hsetlik/Handyman_TunerGate/Simulations/AttenuatorSim.asc

C1: cap; 100n
C2: cap; 47n
C3: cap; 100n
D1: diode; 1N4148
D2: diode; 1N4148
D3: diode; 1N4148
D4: diode; 1N4148
D5: diode; 1N4148
Q1: npn; BC847B
R1: res; 47k
R2: res; 470k
R3: res; 470k
R4: res; 470k
R5: res; 470k
R6: res; 470k
R7: res; 51k
R8: res; 100k
R9: res; 51k
R10: res; 100k
R11: res; 100k
R12: res; 47k
R13: res; 10k
R14: res; 10k
R15: res; 47k
U1: LT1058
U2: LT1058
U3: LT1058
U4: LT1058
U5: LT1058
V1: voltage; PULSE(3.3 0 650m 100u 100u 90m 150m 1)
V2: voltage; 9
V3: voltage; SINE(0 0.4 220)
Named nets: +9, 0, vg, gate, IN, CATH, AN, out
.tran 0 800m 600m
