hsetlik/Handyman_TunerGate/Simulations/ThreshDetectorSim.asc

C1: cap; 470n
C2: cap; 4.7n
C3: cap; 1µ
C4: cap; 100n
C5: cap; 10n
D1: diode; 1N4148
D2: diode; 1N4148
D3: diode; 1N4148
Q1: pnp; BC857A
Q2: pnp; BC857A
R1: res; 4.7k
R2: res; 100k
R3: res; 680
R4: res; 680
R5: res; 4.7k
R6: res; 91k
R7: res; 2k7
R8: res; 470k
R9: res; 22k
R10: res; 100k
R11: res; 100k
R12: res; 820
R13: res; 5k6
R14: res; 100k
R15: res; 100k
R16: res; 50k
R17: res; 100k
R18: res; 470k
R19: res; 10k
R20: res; 100k
U1: LM13700
U2: LT1058
U3: LT1058
U4: LT1058
U6: LT1058
U7: LT1058
U8: LT1058
V1: voltage; SINE(0 0.1 440)
V2: voltage; 9
V3: voltage; 9
V4: voltage; PULSE(0 3.3 600m 10m 60m 30m 100m 1)
Named nets: 0, +9, -9, GTR, vg, rect, env
.tran 0 800m 600m
.lib lm13700.sub
Ignore this it's just a convenient way to simulate a guitar signal
R19 = decay control 10k
