hsetlik/Handyman_TunerGate/HandymanSchematic_F4/HandymanSchematic_F4.kicad_pcb

## KiCad design HandymanSchematic_F4/HandymanSchematic_F4.kicad_pcb (2026-10-26)

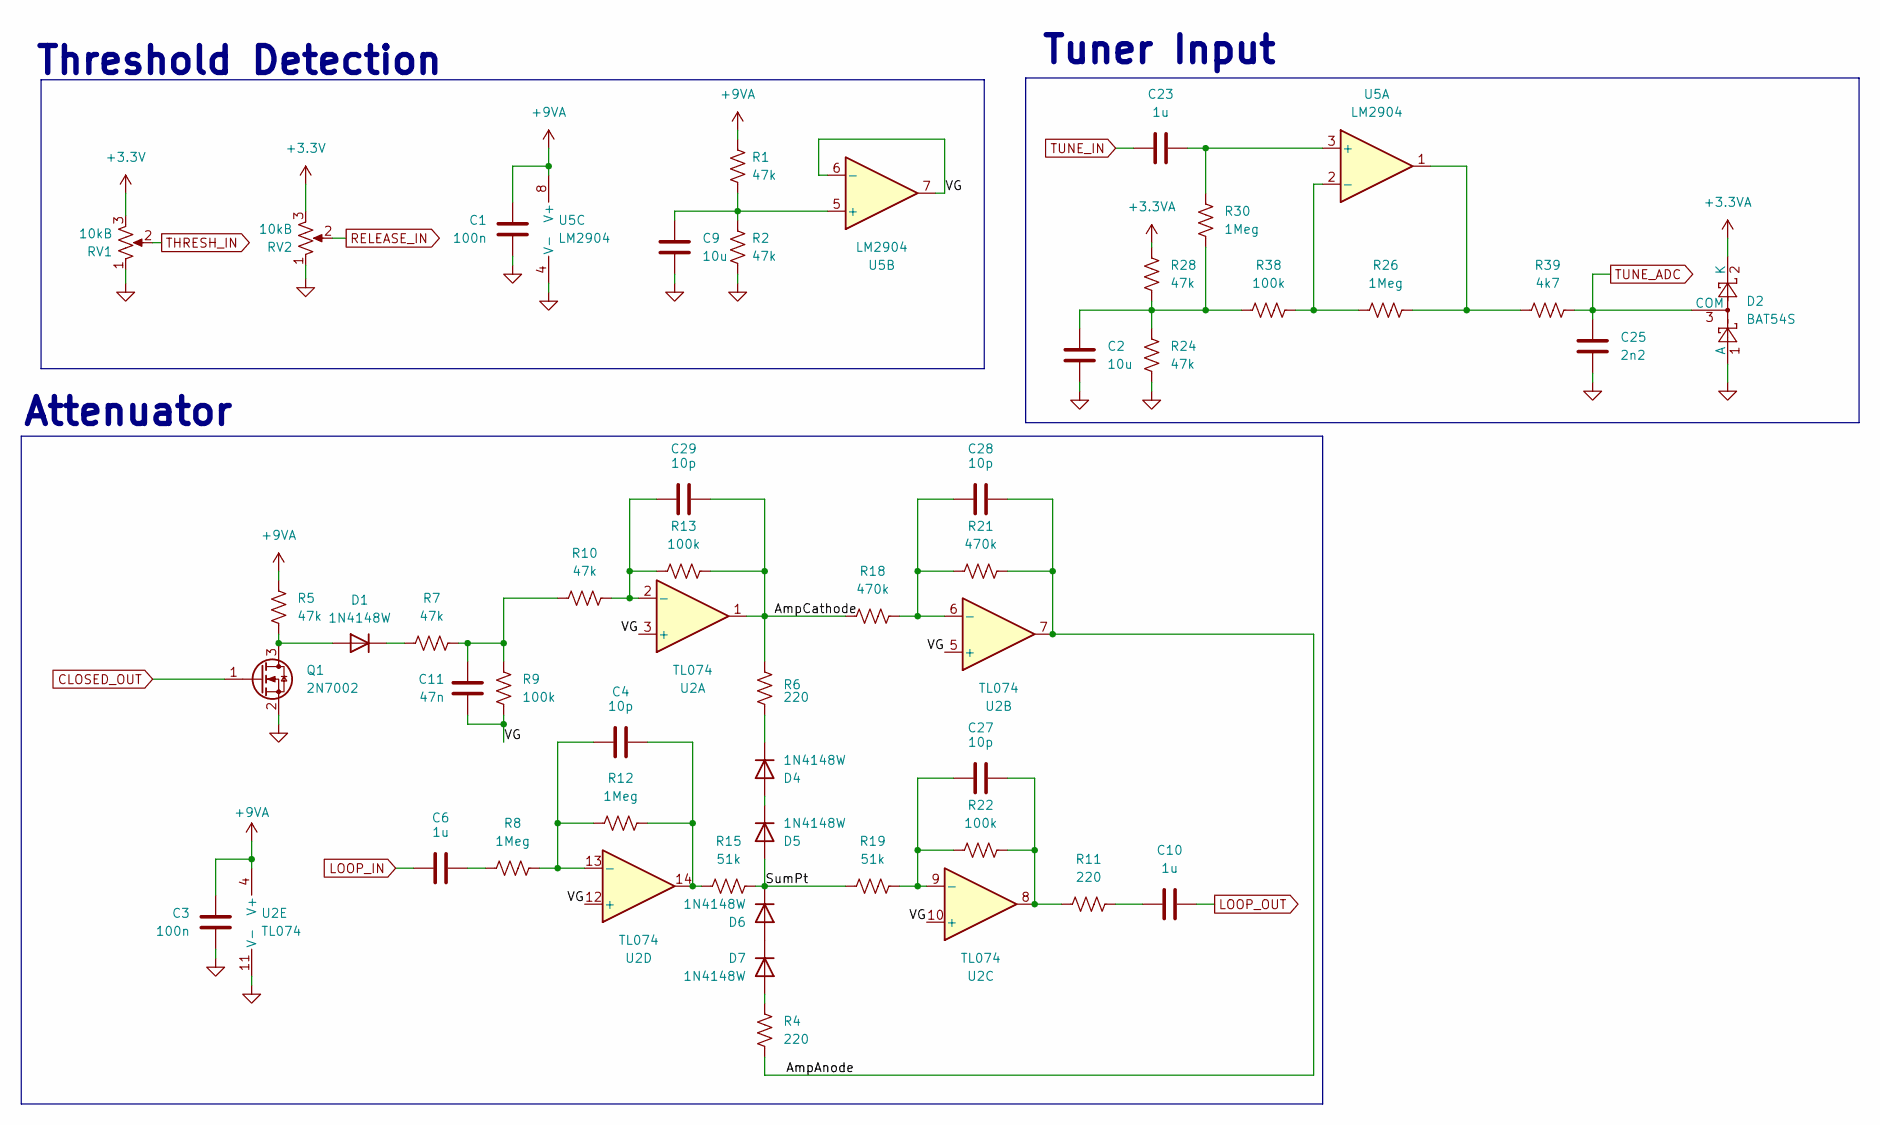
[picture p1: schematic Analog.kicad_sch]

Parts:
C1, C3: 100n; C_0805_2012Metric; MPN KGF21BR71H104KT
C2, C9: 10u; C_0805_2012Metric; MPN KGF21BR71H104KT
C4, C27, C28, C29: 10p; C_0805_2012Metric; MPN KGM21AR51E105KU
C6, C10, C23: 1u; C_0805_2012Metric; MPN KGM21AR51E105KU
C11: 47n; C_0805_2012Metric; MPN KGM21NR71H472JM
C25: 2n2; C_0805_2012Metric; MPN KGF21BR71H104KT
D1, D4, D5, D6, D7: 1N4148W; D_SOD-123; MPN 1N4148W-7-F
D2: BAT54S; SOT-23
Q1: 2N7002; SOT-23
R1, R2, R5, R7, R10, R24, R28: 47k; R_0805_2012Metric; MPN RK73B2ATTE473J
R4, R6, R11: 220; R_0805_2012Metric; MPN RC0805FR-10100KL
R8, R12, R26: 1Meg; R_0805_2012Metric; MPN AC0805JR-07470KL
R9, R22: 100k; R_0805_2012Metric; MPN RC0805FR-10100KL
R13, R38: 100k; R_0805_2012Metric; MPN AC0805JR-07470KL
R15, R19: 51k; R_0805_2012Metric; MPN RT0805FRE0751KL
R18, R21: 470k; R_0805_2012Metric; MPN AC0805JR-07470KL
R30: 1Meg; R_0805_2012Metric; MPN RK73B2ATTE473J
R39: 4k7; R_0805_2012Metric; MPN AC0805JR-07470KL
RV1, RV2: 10kB; Potentiometer_Alpha_RD901F-40-00D_Single_Vertical_CircularH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; MPN RV9022NO-PA30B7.0-B10K-000-W3.0
U2: TL074; SOIC-14_3.9x8.7mm_P1.27mm; MPN TL074HIDR
U5: LM2904; SOIC-8_3.9x4.9mm_P1.27mm

Connections:
+3.3V: RV1.3, RV2.3; also elsewhere on the board
+3.3VA: D2.2 (K), R28.1; also elsewhere on the board
+9VA: C1.1, C3.1, R1.1, R5.1, U2.4 (V+), U5.8 (V+); also elsewhere on the board
/Analog/AmpAnode: C28.2, R4.2, R21.2, U2.7
/Analog/AmpCathode: C29.2, R6.1, R13.2, R18.1, U2.1
/Analog/SumPt: D5.2 (A), D6.1 (K), R15.2, R19.1
/Analog/VG: C11.2, R9.2, U2.3 (+), U2.5 (+), U2.10 (+), U2.12 (+), U5.6 (-), U5.7
CLOSED_OUT: Q1.1 (G); also elsewhere on the board
GND: C1.2, C2.2, C3.2, C9.2, C25.2, D2.1 (A), Q1.2 (S), R2.2, R24.2, RV1.1, RV2.1, U2.11 (V-), U5.4 (V-); also elsewhere on the board
LOOP_IN: C6.1; also elsewhere on the board
LOOP_OUT: C10.2; also elsewhere on the board
unnamed: C2.1, R24.1, R28.2, R30.2, R38.1
unnamed: C4.2, R12.2, R15.1, U2.14
unnamed: C6.2, R8.1
unnamed: C10.1, R11.2
unnamed: C11.1, R7.2, R9.1, R10.1
unnamed: C27.2, R11.1, R22.2, U2.8
unnamed: D1.2 (A), Q1.3 (D), R5.2
unnamed: D1.1 (K), R7.1
unnamed: D4.2 (A), D5.1 (K)
unnamed: D4.1 (K), R6.2
unnamed: D6.2 (A), D7.1 (K)
unnamed: D7.2 (A), R4.1
unnamed: R26.2, R39.1, U5.1
unnamed: C29.1, R10.2, R13.1, U2.2 (-)
unnamed: C28.1, R18.2, R21.1, U2.6 (-)
unnamed: C27.1, R19.2, R22.1, U2.9 (-)
unnamed: C4.1, R8.2, R12.1, U2.13 (-)
unnamed: C23.2, R30.1, U5.3 (+)
unnamed: R26.1, R38.2, U5.2 (-)
unnamed: C9.1, R1.2, R2.1, U5.5 (+)
RELEASE_IN: RV2.2; also elsewhere on the board
THRESH_IN: RV1.2; also elsewhere on the board
TUNE_ADC: C25.1, D2.3 (COM), R39.2; also elsewhere on the board
TUNE_IN: C23.1; also elsewhere on the board

Notes on the sheet:
Threshold Detection
Tuner Input
Attenuator

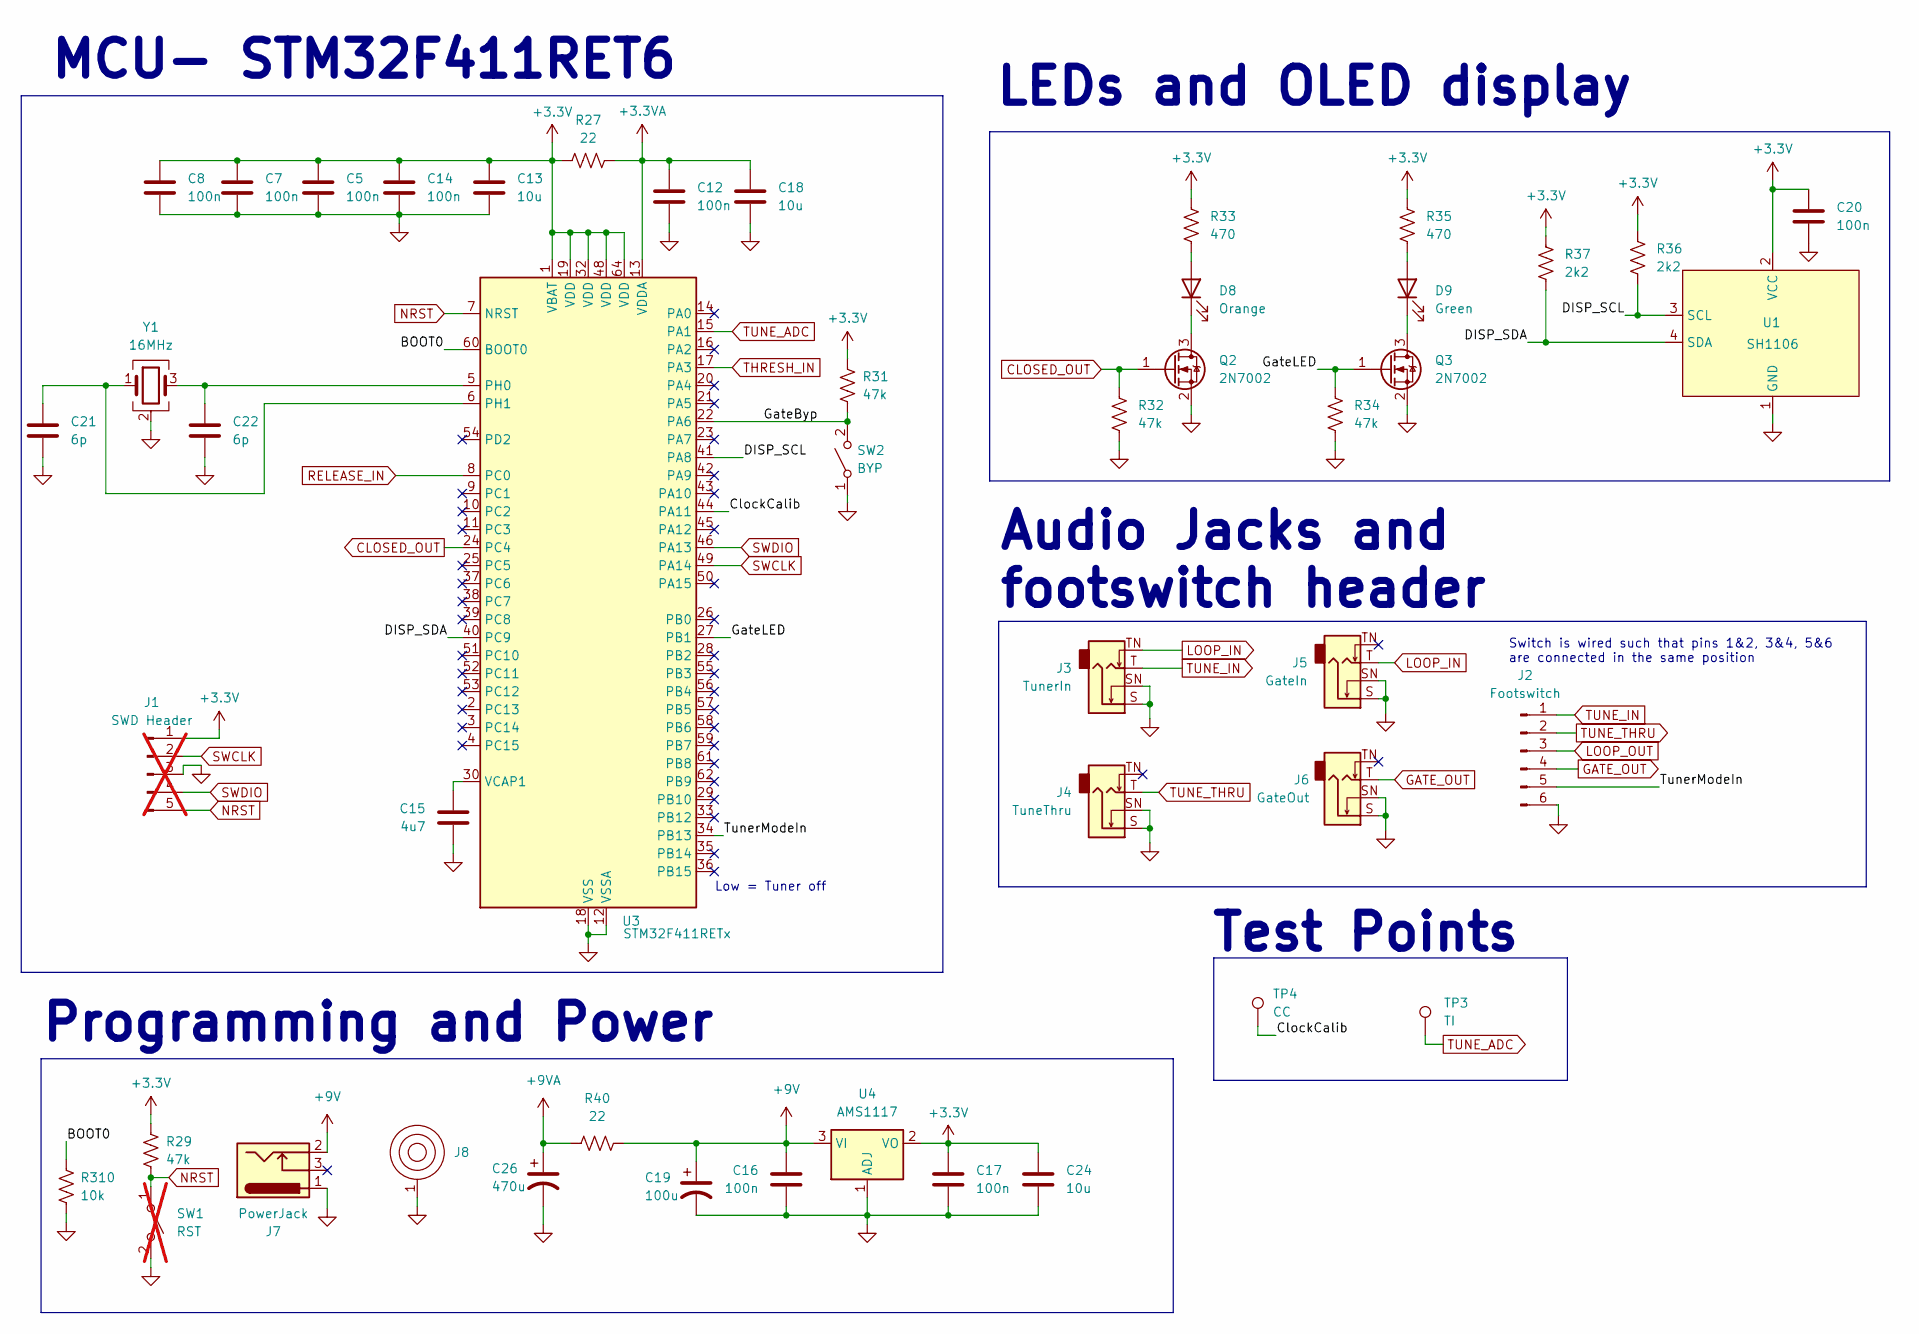
[picture p2: schematic Digital.kicad_sch]

Parts:
C5, C7, C8, C12, C14, C16, C17, C20: 100n; C_0805_2012Metric; MPN KGF21BR71H104KT
C13, C18, C24: 10u; C_0805_2012Metric; MPN KGM21AR50J106KU
C15: 4u7; C_0805_2012Metric; MPN CGA4J3X7R1A475K125AB
C19: 100u; CP_Radial_D5.0mm_P2.50mm; MPN ESH107M010AC3AA
C21, C22: 6p; C_0805_2012Metric; MPN 0805N6R0D500CT
C26: 470u; CP_Radial_D6.3mm_P2.50mm; MPN ESH107M010AC3AA
D8: Orange; LED_D3.0mm; MPN LTL-4291N
D9: Green; LED_D3.0mm; MPN LTL-4231N
J1: SWD Header; PinHeader_1x05_P2.54mm_Vertical; not fitted
J2: Footswitch; PinHeader_1x06_P2.54mm_Vertical; MPN SF17N-0302-21R-L-1.1KG-R
J3: TunerIn; Jack_6.35mm_Tayda_PJ664C_Mono_Horizontal; MPN PJ-644C MONO
J4: TuneThru; Jack_6.35mm_Tayda_PJ664C_Mono_Horizontal; MPN PJ-644C MONO
J5: GateIn; Jack_6.35mm_Tayda_PJ664C_Mono_Horizontal; MPN PJ-644C MONO
J6: GateOut; Jack_6.35mm_Tayda_PJ664C_Mono_Horizontal; MPN PJ-644C MONO
J7: PowerJack; BarrelJack_Horizontal; MPN NEB 21 R-C
J8: BatteryContact_Keystone_243
Q2, Q3: 2N7002; SOT-23; MPN 2N7002NXAKR
R27: 22; R_0805_2012Metric; MPN RC0805JR-0722RL
R29, R31, R32, R34: 47k; R_0805_2012Metric; MPN RK73B2ATTE473J
R33, R35: 470; R_0805_2012Metric; MPN RC0805JR-10470RL
R36, R37: 2k2; R_0805_2012Metric; MPN AC0805FR-072K2L
R40: 22; R_0805_2012Metric; MPN RC0805JR-10470RL
R310: 10k; R_0805_2012Metric; MPN AC0805JR-0710KL
SW1: RST; SW_SPST_B3U-1000P; not fitted
SW2: BYP; SW_TH_Tactile_Omron_B3F-102x; MPN TS02-66-90-BK-100-SCR-D
TP3: TI; TestPoint_THTPad_D2.0mm_Drill1.0mm_VAL
TP4: CC; TestPoint_THTPad_D2.0mm_Drill1.0mm_VAL
U1: SH1106; OLED_SH1106_13_OffBoard; MPN SH1106
U3: STM32F411RETx; LQFP-64_10x10mm_P0.5mm; MPN STM32F411RET6TR
U4: AMS1117; SOT-223-3_TabPin2; MPN LD1117S33CTR
Y1: 16MHz; Crystal_SMD_3225-4Pin_3.2x2.5mm; MPN CX3225FB16000B0FZZH1

Connections:
+3.3V: C5.2, C7.2, C8.2, C13.2, C14.2, C17.2, C20.2, C24.2, J1.1, R27.1, R29.1, R31.1, R33.1, R35.1, R36.1, R37.1, U1.2 (VCC), U3.1 (VBAT), U3.19 (VDD), U3.32 (VDD), U3.48 (VDD), U3.64 (VDD), U4.2 (VO); also elsewhere on the board
+3.3VA: C12.2, C18.2, R27.2, U3.13 (VDDA); also elsewhere on the board
+9V: C16.2, C19.1, J7.2, R40.2, U4.3 (VI)
+9VA: C26.1, R40.1; also elsewhere on the board
/Digital/BOOT0: R310.1, U3.60 (BOOT0)
/Digital/ClockCalib: TP4.1 (1_1), U3.44 (PA11)
/Digital/DISP_SCL: R36.2, U1.3 (SCL), U3.41 (PA8)
/Digital/DISP_SDA: R37.2, U1.4 (SDA), U3.40 (PC9)
/Digital/GateByp: R31.2, SW2.2 (B), U3.22 (PA6)
/Digital/GateLED: Q3.1 (G), R34.2, U3.27 (PB1)
/Digital/TunerModeIn: J2.5, U3.34 (PB13)
CLOSED_OUT: Q2.1 (G), R32.2, U3.24 (PC4); also elsewhere on the board
GATE_OUT: J2.4, J6.T
GND: C5.1, C7.1, C8.1, C12.1, C13.1, C14.1, C15.1, C16.1, C17.1, C18.1, C19.2, C20.1, C21.1, C22.1, C24.1, C26.2, J1.3, J2.6, J3.S, J3.SN, J4.S, J4.SN, J5.S, J5.SN, J6.S, J6.SN, J7.1, J8.1, Q2.2 (S), Q3.2 (S), R32.1, R34.1, R310.2, SW1.2 (B), SW2.1 (A), U1.1 (GND), U3.12 (VSSA), U3.18 (VSS), U3.31 (VSS), U3.47 (VSS), U3.63 (VSS), U4.1 (ADJ), Y1.2 (G), Y1.4 (G); also elsewhere on the board
LOOP_IN: J3.TN, J5.T; also elsewhere on the board
LOOP_OUT: J2.3; also elsewhere on the board
NRST: J1.5, R29.2, SW1.1 (A), U3.7 (NRST)
unnamed: D8.2 (A), R33.2
unnamed: D8.1 (K), Q2.3 (D)
unnamed: D9.2 (A), R35.2
unnamed: D9.1 (K), Q3.3 (D)
unnamed: C22.2, U3.5 (PH0), Y1.3
unnamed: C21.2, U3.6 (PH1), Y1.1
unnamed: C15.2, U3.30 (VCAP1)
RELEASE_IN: U3.8 (PC0); also elsewhere on the board
SWCLK: J1.2, U3.49 (PA14)
SWDIO: J1.4, U3.46 (PA13)
THRESH_IN: U3.17 (PA3); also elsewhere on the board
TUNE_ADC: TP3.1 (1_1), U3.15 (PA1); also elsewhere on the board
TUNE_IN: J2.1, J3.T; also elsewhere on the board
TUNE_THRU: J2.2, J4.T

Notes on the sheet:
LEDs and OLED display
Programming and Power
Audio Jacks and footswitch header
Switch is wired such that pins 1&2, 3&4, 5&6 are connected in the same position
Low = Tuner off
MCU- STM32F411RET6
Test Points

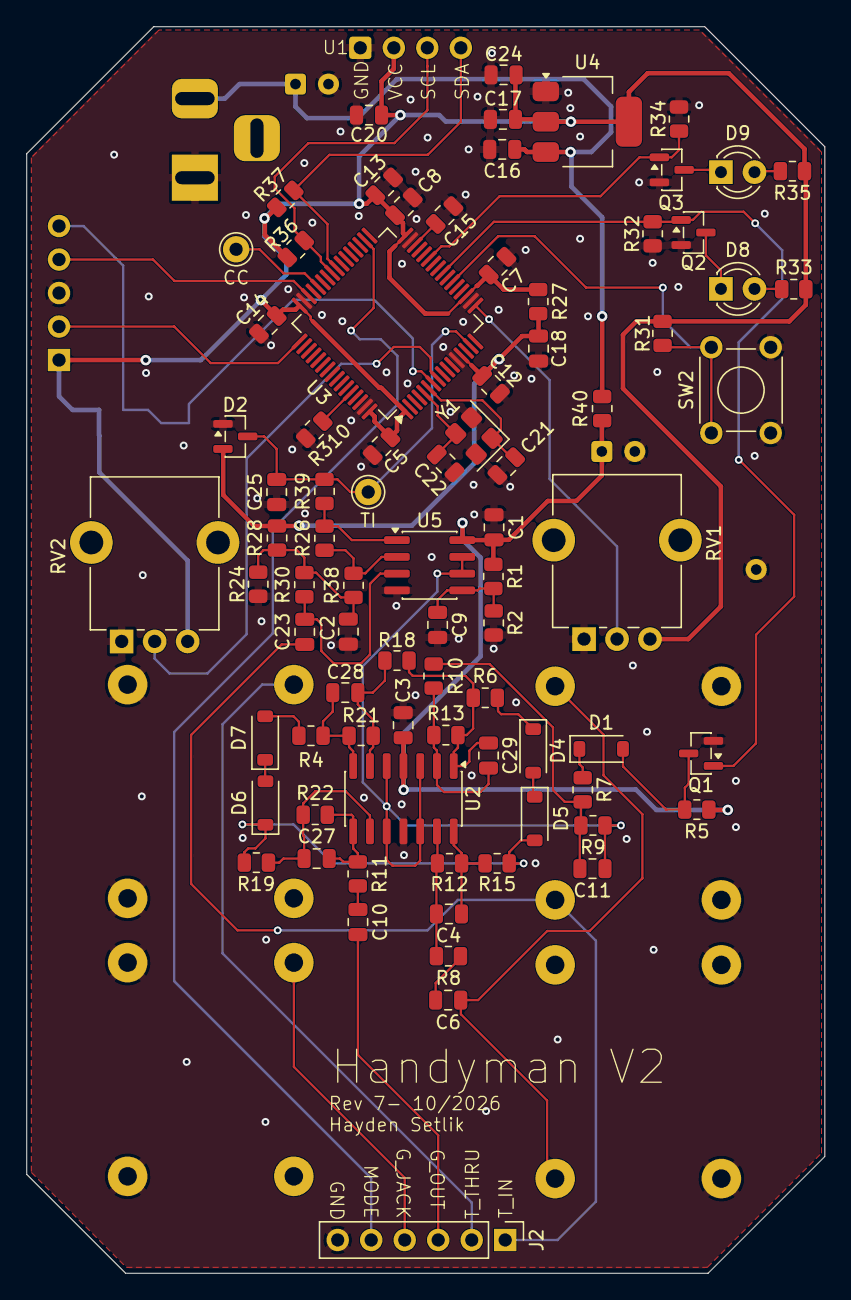
[picture p3: board HandymanSchematic_F4.kicad_pcb from above]

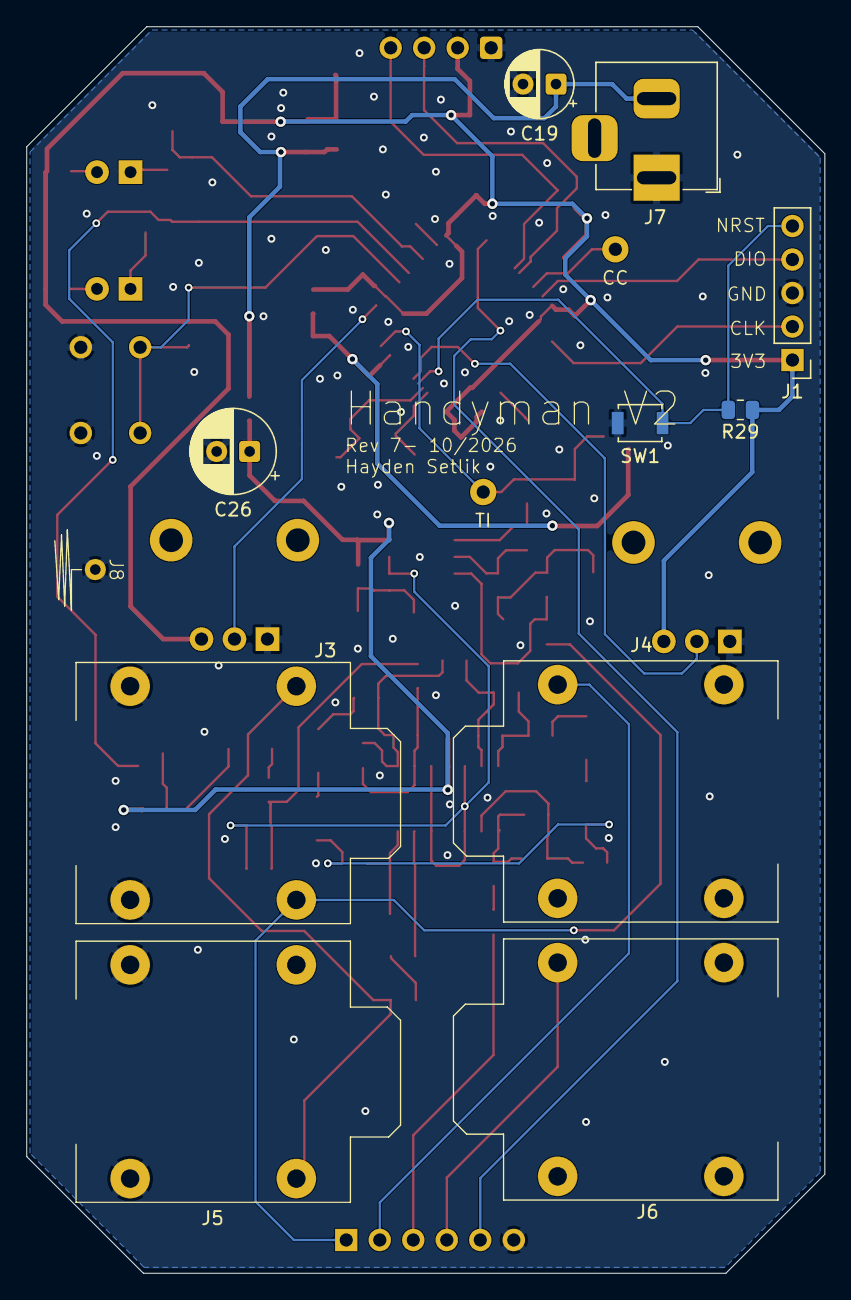
[picture p4: board HandymanSchematic_F4.kicad_pcb from below]

Board: 4 copper layers, 60.5 x 94.5 mm, 94 parts (11 on the bottom side), 55 nets.
