hsetlik/Handyman_TunerGate/HandymanFirmware_F4/Core/Src/main.c

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
/* Includes ------------------------------------------------------------------*/
#include "main.h"

/* USER CODE BEGIN Includes */
#include "BitstreamACF.h"
#include "Tuning.h"
#include "sh1106.h"
#include "DisplayChars.h"
//#include "ssd1306_fonts.h"
#include "NoiseGate.h"
#include "stm32f4xx_hal.h"
#include "stm32f4xx_hal_adc_ex.h"
#include "stm32f4xx_hal_def.h"
#include "stm32f4xx_hal_gpio.h"
#include "stm32f4xx_hal_tim.h"
#include "stm32f4xx_it.h"
#include <string.h>
#include <stdlib.h>

/* USER CODE END Includes */

/* USER CODE BEGIN PD */
#define IN_TUNE_THRESH 4

//#define DISPLAY_VERTICAL
/* USER CODE END PD */

ADC_HandleTypeDef hadc1;
DMA_HandleTypeDef hdma_adc1;

I2C_HandleTypeDef hi2c3;

TIM_HandleTypeDef htim2;
TIM_HandleTypeDef htim3;
TIM_HandleTypeDef htim5;

/* USER CODE BEGIN PV */
// DMA fills this buffer with the ADC values
uint16_t tuningBuffer[TUNING_WINDOW_SIZE * 2];
uint16_t noiseGateBuffer[GATE_WINDOW_SIZE * 2];
// flags for tuner/noise gate modes
bool inTunerMode = false;
bool useNoiseGate = true;
volatile bool tunerDmaRunning = false;
volatile bool gateDmaRunning = false;
volatile bool noiseGateClosed = true;
uint32_t lastUpdateTick = 0;

/* USER CODE END PV */

void SystemClock_Config(void);
static void MX_GPIO_Init(void);
static void MX_DMA_Init(void);
static void MX_ADC1_Init(void);
static void MX_TIM2_Init(void);
static void MX_TIM3_Init(void);
static void MX_TIM5_Init(void);
static void MX_I2C3_Init(void);
/* USER CODE BEGIN PFP */
// check the GPIOs to set the above `inTunerMode` and `useNoiseGate` flags
// call this once before the main while loop and again in the ISR for TIM3
// (which is 10x/second with current settings)
void checkModeSettings();

// draw the current tuning error to the display
void displayTuningError(tuning_error_t *err);
// draw a blank screen if we don't have valid tuning data
void displayBlankTuning();
/* USER CODE END PFP */

/* USER CODE BEGIN 0 */
void checkModeSettings() {
  // 1. read the GPIOs to determine what state we should be in
  GPIO_PinState tuneState =
      HAL_GPIO_ReadPin(TunerMode_IN_GPIO_Port, TunerMode_IN_Pin);
  // GPIO_PinState useGateState =
  //     HAL_GPIO_ReadPin(UseGate_IN_GPIO_Port, UseGate_IN_Pin);
  inTunerMode = tuneState == GPIO_PIN_SET;
  //useNoiseGate = useGateState == GPIO_PIN_SET;
  const bool gateLEDOn = useNoiseGate && (!inTunerMode);
  const bool oledIsOn = SH1106_isDisplayOn();
  if (inTunerMode != oledIsOn) {
    if(!inTunerMode)
      displayBlankTuning();
    SH1106_DisplayOn((uint8_t)inTunerMode);
  } 
  setUseGateLED(gateLEDOn);
  if(inTunerMode && !tunerDmaRunning){
    if(gateDmaRunning){
      stopNoiseGateDMA();
    }
    startTunerDMA();
    setNoiseGateClosed(true);
  } else if (!inTunerMode && useNoiseGate){
    if(tunerDmaRunning){
      stopTunerDMA();
    }
    if(!gateDmaRunning){
      startNoiseGateDMA();
    }
  } else if (!useNoiseGate && gateDmaRunning){
    stopNoiseGateDMA();
  }
  if(!useNoiseGate && !inTunerMode){
    setNoiseGateClosed(false);
  }
}

char *noteNames[12] = {"C",  "C#", "D",  "D#", "E",  "F",
                             "F#", "G",  "G#", "A",  "A#", "B"};

const uint8_t* noteDataHorizontal[12] = {DisplayChar_C, DisplayChar_CSharp, DisplayChar_D, DisplayChar_DSharp, DisplayChar_E, DisplayChar_F, DisplayChar_FSharp, DisplayChar_G, DisplayChar_GSharp, DisplayChar_A, DisplayChar_ASharp, DisplayChar_B};
const uint8_t* noteDataVertical[12] = {DisplayChar_C_Vertical, DisplayChar_CSharp_Vertical, DisplayChar_D_Vertical, DisplayChar_DSharp_Vertical, DisplayChar_E_Vertical, DisplayChar_F_Vertical, DisplayChar_FSharp_Vertical, DisplayChar_G_Vertical, DisplayChar_GSharp_Vertical, DisplayChar_A_Vertical, DisplayChar_ASharp_Vertical, DisplayChar_B_Vertical};
float errorSkew = 0.0f;
#define TUNE_ERROR_MIN 0.0f
#define TUNE_ERROR_MAX 64.0f
#define TUNE_ERROR_CENTER 20.0f
static float getErrorSkew(){
  return logf(0.5f) / logf((TUNE_ERROR_CENTER - TUNE_ERROR_MIN) / (TUNE_ERROR_MAX - TUNE_ERROR_MIN));
}                            

uint8_t barWidthForError(int16_t sErrorCents){
  const float normError = (float)abs(sErrorCents) / 50.0f;
  const float proportion = expf(logf(normError) / errorSkew); 
  return (uint8_t)(TUNE_ERROR_MAX * proportion);

}

void displayTuningError(tuning_error_t *err) {
  //char* noteName = noteNames[err->midiNote % 12];
  SH1106_Fill(SH1106_COLOR_BLACK);
  //check if we're within the tuning threshold
  if(abs(err->errorCents) <= IN_TUNE_THRESH){
#ifndef DISPLAY_VERTICAL
    const uint8_t* noteBits = noteDataHorizontal[err->midiNote % 12];
    SH1106_Fill(SH1106_COLOR_WHITE);
    SH1106_DrawBitmap(21, 11, noteBits,
                  DISPLAY_CHAR_W_HORIZONTAL, DISPLAY_CHAR_H_HORIZONTAL, DISPLAY_CHAR_STRIDE_HORIZONTAL, false);
#else

    const uint8_t* noteBits = noteDataVertical[err->midiNote % 12];
    SH1106_Fill(SH1106_COLOR_WHITE);
    //SH1106_DrawRectangle(43, 2, DISPLAY_CHAR_W_VERTICAL, DISPLAY_CHAR_STRIDE_VERTICAL, SH1106_COLOR_WHITE);
    SH1106_DrawBitmapRotatedCW90(43, 2, noteBits,
             DISPLAY_CHAR_W_VERTICAL,DISPLAY_CHAR_H_VERTICAL, DISPLAY_CHAR_STRIDE_VERTICAL, false);
#endif
  } else {
#ifndef DISPLAY_VERTICAL
    const uint8_t* noteBits = noteDataHorizontal[err->midiNote % 12];
    SH1106_Fill(SH1106_COLOR_BLACK);
    // draw the note
    SH1106_DrawBitmap(21, 11, noteBits,
                  DISPLAY_CHAR_W_HORIZONTAL, DISPLAY_CHAR_H_HORIZONTAL, DISPLAY_CHAR_STRIDE_HORIZONTAL, true);
    // draw the tuning error bar
    const uint8_t xCenter = 64;
    const uint8_t barY = 51;
    const uint8_t barHeight = 8;
    // draw the center divider line
    SH1106_DrawRectangle(62, 48, 4, 15, SH1106_COLOR_WHITE);
    // draw the error bar
    uint8_t barWidth = barWidthForError(err->errorCents);
    uint8_t x;
    if(err->errorCents > 0){
      x = xCenter;
    } else {
      x = xCenter - barWidth;
    }
    SH1106_DrawRectangle(x, barY, barWidth, barHeight, SH1106_COLOR_WHITE);
#else
    const uint8_t* noteBits = noteDataVertical[err->midiNote % 12];
    SH1106_Fill(SH1106_COLOR_BLACK);
    SH1106_DrawBitmapRotatedCW90(43, 2, noteBits,
                  DISPLAY_CHAR_W_VERTICAL, DISPLAY_CHAR_H_VERTICAL, DISPLAY_CHAR_STRIDE_VERTICAL, true);
    // draw the center of the error bar
    SH1106_DrawRectangle(62, 53, 4, 10, SH1106_COLOR_WHITE);
    uint8_t barWidth = barWidthForError(err->errorCents);
    uint8_t x;
    const uint8_t xCenter = 64;
    if(err->errorCents > 0){
      x = xCenter;
    } else {
      x = xCenter - barWidth;
    }
    SH1106_DrawRectangle(x, 55, barWidth, 6, SH1106_COLOR_WHITE);

#endif
  }
  // // 6. send the I2C data to update the screen
  SH1106_UpdateScreen();
}


void displayBlankTuning(){
  SH1106_Fill(SH1106_COLOR_BLACK);
  SH1106_UpdateScreen();
}
// Implementations of shared stuff from main.h---------------------------------------------------

void startTunerDMA(){
  HAL_StatusTypeDef dmaStatus = HAL_ADC_Start_DMA(&hadc1, (uint32_t *)tuningBuffer, TUNING_WINDOW_SIZE * 2);
  if(dmaStatus != HAL_OK){
    Error_Handler();
  }
  HAL_StatusTypeDef timerStatus = HAL_TIM_Base_Start(&htim2);
  if(timerStatus != HAL_OK){
    Error_Handler();
  }
  tunerDmaRunning = true;
}


void stopTunerDMA(){
  HAL_StatusTypeDef timerStatus = HAL_TIM_Base_Stop(&htim2);
  if(timerStatus != HAL_OK){
    Error_Handler();
  }
  HAL_StatusTypeDef dmaStatus = HAL_ADC_Stop_DMA(&hadc1);
  if(dmaStatus != HAL_OK){
    Error_Handler();
  }
  tunerDmaRunning = false;
}

void startNoiseGateDMA(){
  HAL_StatusTypeDef dmaStatus = HAL_ADC_Start_DMA(&hadc1, (uint32_t *)noiseGateBuffer, GATE_WINDOW_SIZE * 2);
  if(dmaStatus != HAL_OK){
    Error_Handler();
  }
  HAL_StatusTypeDef timerStatus = HAL_TIM_Base_Start(&htim2);
  if(timerStatus != HAL_OK){
    Error_Handler();
  }
  gateDmaRunning = true;
}

void stopNoiseGateDMA(){
  HAL_StatusTypeDef timerStatus = HAL_TIM_Base_Stop(&htim2);
  if(timerStatus != HAL_OK){
    Error_Handler();
  }
  HAL_StatusTypeDef dmaStatus = HAL_ADC_Stop_DMA(&hadc1);
  if(dmaStatus != HAL_OK){
    Error_Handler();
  }
  gateDmaRunning = false;
}

bool readyToClearScreen(){
  uint32_t now = HAL_GetTick();
  return (now - lastUpdateTick) > 600;
}

void setUseGateLED(bool ledOn){
  GPIO_PinState state = ledOn ? GPIO_PIN_SET : GPIO_PIN_RESET;
  HAL_GPIO_WritePin(UseGate_OUT_GPIO_Port, UseGate_OUT_Pin, state);
}

void setNoiseGateClosed(bool gateClosed){
  if(noiseGateClosed != gateClosed){
    noiseGateClosed = gateClosed;
    GPIO_PinState state = noiseGateClosed ? GPIO_PIN_RESET : GPIO_PIN_SET;
    HAL_GPIO_WritePin(GateClosed_OUT_GPIO_Port, GateClosed_OUT_Pin, state);
  }
}


void startPotADCConversion(){
  // 1. trigger the software injection
  HAL_StatusTypeDef startStatus = HAL_ADCEx_InjectedStart(&hadc1);
  if(startStatus != HAL_OK){
    Error_Handler();
  }
  // 2. block until the conversion is done
  HAL_StatusTypeDef pollStatus = HAL_ADCEx_InjectedPollForConversion(&hadc1, HAL_MAX_DELAY);
  if(pollStatus != HAL_OK){
    Error_Handler();
  }
}

static uint16_t gateBtnState = 0xFFFF;
void checkGateButton() {
  gateBtnState = (gateBtnState << 1) | HAL_GPIO_ReadPin(UseGate_IN_GPIO_Port, UseGate_IN_Pin);
  if(gateBtnState == 0xFFF0){
    useNoiseGate = !useNoiseGate;
  }
}

/* USER CODE END 0 */

/**
  * @brief  The application entry point.
  * @retval int
  */
int main(void)
{

  /* MCU Configuration--------------------------------------------------------*/

  /* Reset of all peripherals, Initializes the Flash interface and the Systick. */
  HAL_Init();

  /* Configure the system clock */
  SystemClock_Config();

  /* Initialize all configured peripherals */
  MX_GPIO_Init();
  MX_DMA_Init();
  MX_ADC1_Init();
  MX_TIM2_Init();
  MX_TIM3_Init();
  MX_TIM5_Init();
  MX_I2C3_Init();
  /* USER CODE BEGIN 2 */
  // calculate the skew for the error bar
  errorSkew = getErrorSkew();
  // Initialize the buffers for the BAC handling
  BAC_initBitArray();
  // initialize the noise gate
  Gate_initNoiseGate();

  // initialize the OLED

  if(SH1106_Init() != HAL_OK){
    Error_Handler();
  }

  HAL_Delay(200);
  // check the GPIO inputs for the first time and start the relevant DMA streams
  checkModeSettings();
  // start timer 3 for checking mode settings
  HAL_TIM_Base_Start_IT(&htim3);
  // start timer 5 for checking the gate button
  HAL_TIM_Base_Start_IT(&htim5);
  /* USER CODE END 2 */

  /* Infinite loop */
  /* USER CODE BEGIN WHILE */
  while (1) {
    if (inTunerMode && BAC_isBitstreamReady()) {
      BAC_run();
      if(BAC_hasTuningSignal()){
        // 1. run the BAC algorithm
        const float currentHz = BAC_getCurrentHz();
        // 2. convert to an error value
        tuning_error_t err = Tune_getErrorForFreq(currentHz);
        // 3. display the error
        displayTuningError(&err);
        lastUpdateTick = HAL_GetTick();
      } else if (readyToClearScreen()) {
        displayBlankTuning();
      }
      // 4. Unset the bitstreamLoaded flag
      BAC_finishedWithCurrentHz();
    }

    /* USER CODE END WHILE */

    /* USER CODE BEGIN 3 */
  }
  /* USER CODE END 3 */
}

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
/* USER CODE BEGIN 4 */
//========================================================================================
// Audio ADC callback
void HAL_ADC_ConvCpltCallback(ADC_HandleTypeDef *hadc) {
  // compute the second half of the buffer
  if (inTunerMode) {
    // if(BAC_isWorking()){
    //   Error_Handler();
    // }
    uint16_t* startPtr = &tuningBuffer[TUNING_WINDOW_SIZE];
    BAC_loadBitstream(startPtr);
    HAL_StatusTypeDef dmaStatus = HAL_ADC_Start_DMA(&hadc1, (uint32_t *)tuningBuffer, TUNING_WINDOW_SIZE * 2);
    if(dmaStatus != HAL_OK){
      Error_Handler();
    }
  } else if (useNoiseGate) {
    uint16_t* startPtr = &noiseGateBuffer[GATE_WINDOW_SIZE];
    Gate_processWindow(startPtr, GATE_WINDOW_SIZE);
    // update the pots here if it's time
    if(Gate_isAwaitingPotReadings()){
      startPotADCConversion();
      uint32_t threshVal = HAL_ADCEx_InjectedGetValue(&hadc1, ADC_INJECTED_RANK_1);
      uint32_t releaseVal = HAL_ADCEx_InjectedGetValue(&hadc1, ADC_INJECTED_RANK_2);
      Gate_updatePotReadings((uint16_t)threshVal, (uint16_t)releaseVal);
    }
    HAL_ADC_Start_DMA(&hadc1, (uint32_t *)noiseGateBuffer, GATE_WINDOW_SIZE * 2);
  }
}

void HAL_ADC_ConvHalfCpltCallback(ADC_HandleTypeDef *hadc) {
  // compute the first half of the buffer
  if(inTunerMode){
    // if(BAC_isWorking()){
    //   Error_Handler();
    // }
    BAC_loadBitstream(tuningBuffer);
  } else if (useNoiseGate) {
    Gate_processWindow(noiseGateBuffer, GATE_WINDOW_SIZE);
  }
}

void HAL_TIM_PeriodElapsedCallback(TIM_HandleTypeDef *htim) {
  if (htim == &htim3) {
    checkModeSettings();
    if(useNoiseGate && !inTunerMode){
      Gate_requestPotReadings();
    }
  } else if (htim == &htim5){
    checkGateButton();
  }
}


/* USER CODE END 4 */
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
