hsetlik/Handyman_TunerGate/HandymanFirmware_F4/HandymanFirmware_F4.ioc

Mcu.UserName=STM32F411RETx
PA1.GPIO_Label=Audio_IN
PA1.Signal=ADCx_IN1
PA11.GPIO_Label=Clock_Calib
PA11.Signal=GPIO_Output
PA13.Signal=SYS_JTMS-SWDIO
PA14.Signal=SYS_JTCK-SWCLK
PA3.GPIO_Label=Threshold_IN
PA3.Signal=ADCx_IN3
PA6.GPIO_Label=UseGate_IN
PA6.Signal=GPIO_Input
PA8.GPIO_Label=DISP_SCL
PA8.Signal=I2C3_SCL
PB1.GPIO_Label=UseGate_OUT
PB1.Signal=GPIO_Output
PB13.GPIO_Label=TunerMode_IN
PB13.Signal=GPIO_Input
PC0.GPIO_Label=Release_IN
PC0.Signal=ADCx_IN10
PC4.GPIO_Label=GateClosed_OUT
PC4.Signal=GPIO_Output
PC9.GPIO_Label=DISP_SDA
PC9.Signal=I2C3_SDA
