hsetlik/Handyman_TunerGate/HandymanFirmware_F4/Core/Inc/BitstreamACF.h

#ifndef BITSTREAM_ACF_H
#define BITSTREAM_ACF_H
#include "main.h"
#include "IIR.h"
// the type we'll use to store the bitstreams
#define bitval_t uint32_t
#define TUNING_WINDOW_SIZE 2048
#define INPUT_CUTOFF_FREQ 2500.0f

#define BAC_PREFILTER

/* This is based on Joel de Guzman's Bitstream Autocorrelation concept, explained
in his 2018 blog post here:
https://www.cycfi.com/2018/03/fast-and-efficient-pitch-detection-bitstream-autocorrelation/
Code works more or less the same as Guzman's C++ implementation here:
https://github.com/cycfi/bitstream_autocorrelation
but in C (duh) 
*/

//#define BAC_FIND_EDGES


//call this at startup
void BAC_initBitArray();

// get/set for the bit array
bool BAC_get(uint32_t i);
void BAC_set(uint32_t i, bool val);

// call this on the filled ADC buffer to load data into the bitstream
void BAC_loadBitstream(uint16_t* adcBuf);

// check if we've gotten a usable signal
bool BAC_hasTuningSignal();

// the actual autocorellation happens here. the input is a buffer of half the window size
void BAC_run();

// check if we're ready to run the algorithm
bool BAC_isBitstreamReady();

// state-based checking for zero crossings
bool BAC_isZeroCross(bool* prevState, float value);

// check if the algorithm is currently working (for debug reasons)
bool BAC_isWorking();

// return the current best guess for the fundamental frequency in the correlation buffer
float BAC_getCurrentHz();

// call this after displaying the current tuning error
void BAC_finishedWithCurrentHz();

#endif
