hsetlik/Handyman_TunerGate/HandymanFirmware_F4/Core/Inc/IIR.h

#ifndef IIR_H
#define IIR_H
#include "main.h"
#include <math.h>
/*
Super simple first-order IIR lowpass filter.
Relevant math is explained here: https://www.dsprelated.com/showarticle/1769.php
*/

typedef struct {
    float alpha;
    float y1;
} iir_t;

float iir_getAlpha(float fCutoff);

float iir_process(iir_t* filter, float input);

uint16_t iir_process_uint16(iir_t* filter, uint16_t input);

#endif
