hsetlik/Handyman_TunerGate/(commit log)

2025-02-08 attenuator & env follower sim
    [Analog.kicad_sch, HandymanSchematic_G0.kicad_sch]
2025-02-09 diode attenuator sim
2025-02-09 noise gate analog side schem
    [Analog.kicad_sch]
2025-02-09 tuner input circuitry
    [Analog.kicad_sch]
2025-02-09 mcu basics
    [Analog.kicad_sch, Digital.kicad_sch, HandymanSchematic_G0.kicad_sch]
2025-02-09 prelim pinout
    [Analog.kicad_sch, Digital.kicad_sch]
2025-02-09 attenuator input change
    [Analog.kicad_sch, Digital.kicad_sch]
2025-02-09 digital side schematic
    [Digital.kicad_sch]
2025-02-09 added drivers to git duh
2025-02-09 basic interrupt tuner implementation
2025-02-09 footprints chosen, test points
    [Analog.kicad_sch, Digital.kicad_sch]
2025-02-10 footprints, enclosure areas drawn
    [Analog.kicad_sch, Digital.kicad_sch, HandymanSchematic_G0.kicad_pcb]
2025-02-10 control/encoder layout
    [HandymanSchematic_G0.kicad_pcb]
2025-02-10 mode switching handling
    [Digital.kicad_sch]
2025-02-10 cleaned old OLED driver
2025-02-10 re-added OLED driver
2025-02-11 analog side layout
    [Analog.kicad_sch, HandymanSchematic_G0.kicad_pcb]
2025-02-12 rough layout
    [Analog.kicad_sch, Digital.kicad_sch, HandymanSchematic_G0.kicad_pcb]
2025-02-12 routed & DRC passing
    [HandymanSchematic_G0.kicad_pcb]
2025-02-12 silkscreen and stitching vias
    [HandymanSchematic_G0.kicad_pcb]
2025-02-12 rev1 ready for fab
    [HandymanSchematic_G0.kicad_pcb]
2025-02-14 added html bom
    [HandymanSchematic_G0.kicad_pcb]
2025-07-03 noise gate ISR fixed
    [main.c]
2025-07-04 fixed LED logic
2025-07-05 back to timer mode
2025-07-05 set up HSI calibration
2025-07-06 gate bypass/switch handling fixes
    [main.c]
2025-07-06 removed unused components
    [Analog.kicad_sch, Digital.kicad_sch]
2025-07-06 board outline for 1590B size
    [Analog.kicad_sch, Digital.kicad_sch, HandymanSchematic_G0.kicad_pcb]
2025-07-06 analog tweaks, 2 fewer op amps
    [Analog.kicad_sch, HandymanSchematic_G0.kicad_pcb]
2025-07-06 simplified attenuator input stage
    [Analog.kicad_sch, Digital.kicad_sch]
2025-07-07 prelim layout
    [Analog.kicad_sch, Digital.kicad_sch, HandymanSchematic_G0.kicad_pcb]
2025-07-07 routed, DRC passing
    [Digital.kicad_sch, HandymanSchematic_G0.kicad_pcb]
2025-07-07 silkscreen and tweaks
    [HandymanSchematic_G0.kicad_pcb]
2025-10-12 switched timer to 200us
2025-10-13 wired up 'listening' code
2026-02-05 boilerplate for F4 version
    [Analog.kicad_sch, HandymanSchematic_F4.kicad_sch]
2026-02-05 attenuator simulation in kicad
    [AttenuatorSim.kicad_pcb, AttenuatorSim.kicad_sch, Digital.kicad_sch, HandymanSchematic_F4.kicad_pcb, HandymanSchematic_F4.kicad_sch]
2026-02-05 tweaks to analog circuit
    [Analog.kicad_sch, AttenuatorSim.kicad_sch]
2026-02-05 F4 wired up on schem, footprints assigned
    [Analog.kicad_sch, Digital.kicad_sch, HandymanSchematic_G0.kicad_pcb]
2026-02-06 switched to firmware env, new layout
    [Analog.kicad_sch, Digital.kicad_sch, HandymanSchematic_F4.kicad_pcb]
2026-02-06 prelim routing
    [HandymanSchematic_F4.kicad_pcb]
2026-02-06 prettier routing, DRC passing
    [Analog.kicad_sch, HandymanSchematic_F4.kicad_pcb]
2026-02-07 switched to double-buffer DMA for audio input
2026-02-08 added potentiometer channels to DMA stream
2026-02-08 handling for Tuner/noise gate modes
    [HandymanFirmware_F4.ioc, main.c]
2026-02-09 bitstream autocorrelation implemented
    [Analog.kicad_sch, Digital.kicad_sch, HandymanSchematic_F4.kicad_pcb, HandymanSchematic_G0.kicad_pcb, HandymanSchematic_G0.kicad_sch]
2026-02-11 oops switched char* type
2026-02-12 conversions and i2c display working
2026-02-13 v2 gerbers ready
    [Digital.kicad_sch, HandymanSchematic_F4.kicad_pcb]
2026-02-13 minor tweaks for DRC
    [HandymanSchematic_F4.kicad_pcb]
2026-02-13 slightly narrower board routed
    [HandymanSchematic_F4.kicad_pcb]
2026-02-14 routing prettified, stitching vias, silkscreen
    [HandymanSchematic_F4.kicad_pcb]
2026-02-14 moved some stuff to public prototypes in main.h
2026-02-15 noise gate chunk processing
    [NoiseGate.c, NoiseGate.h, main.c]
2026-02-16 switched bac to single conversion in DMA stream
2026-03-02 added BOM
    [HandymanSchematic_F4.kicad_pcb]
2026-03-09 new prelim routing, DRC passing
    [Analog.kicad_sch, AttenuatorSim.kicad_sch, Digital.kicad_sch, HandymanSchematic_F4.kicad_pcb]
2026-03-10 stitching vias, trace niceties
    [HandymanSchematic_F4.kicad_pcb]
2026-03-10 removed acute angles, slikscreen stuff
    [HandymanSchematic_F4.kicad_pcb]
2026-03-16 minor nudges for rev2
    [HandymanSchematic_F4.kicad_pcb]
2026-03-16 rev2 sent to fab
    [HandymanSchematic_F4.kicad_pcb]
2026-03-25 firmware flashing on rev2 board wooo
    [HandymanSchematic_F4.kicad_pcb]
2026-03-26 mirroring fixed, changed some resistor values
    [Analog.kicad_sch]
2026-03-28 switched to using both halves of buffer w/o rising edge offset
2026-03-28 added rising edge to BAC, switched to builtin_popcount
2026-03-29 made tuning stick on screen longer, fixed color inversion for in tune
    [main.c, main.h]
2026-03-29 switched to 56k sample rate
2026-03-29 slightly shorter screen hold
    [main.c]
2026-03-30 switched to separate buffers and window sizes for tuning & noise gate
    [BitstreamACF.c, BitstreamACF.h, NoiseGate.h, main.c, main.h]
2026-03-30 fixed noise gate open/close
    [BitstreamACF.c, BitstreamACF.h, NoiseGate.c, main.c]
2026-03-30 fixed gate close/open polarity
    [main.c]
2026-04-01 value trimming, fixed useGate cycling
    [NoiseGate.c, NoiseGate.h, main.c]
2026-04-01 switched to 72M clock and 48k sample rate
2026-04-10 new & improved noise gate algorithm
    [NoiseGate.c, NoiseGate.h, main.c]
2026-04-13 fixed tuner screen sometimes not clearing
    [BitstreamACF.c, main.c]
2026-04-17 more noise gate tweaks
    [BitstreamACF.c, NoiseGate.h]
2026-05-05 input IIR filter for noise gate
    [IIR.c, IIR.h, NoiseGate.c, NoiseGate.h, main.h]
2026-05-05 input IIR filters on both tuner and noise gate
    [BitstreamACF.c, BitstreamACF.h, NoiseGate.c, NoiseGate.h, main.c]
2026-06-14 basic st7789 stuff
    [Analog.kicad_sch, Digital.kicad_sch, HandymanSchematic_F4.kicad_sch]
2026-06-14 schem changes for new display
    [Analog.kicad_sch, Digital.kicad_sch]
2026-06-14 beginnings of new layout
    [Analog.kicad_sch, Digital.kicad_sch, HandymanSchematic_F4.kicad_pcb]
2026-06-17 im routed
    [Digital.kicad_sch, HandymanSchematic_F4.kicad_pcb]
2026-06-17 elbow room, stitching vias, DRC passing
    [HandymanSchematic_F4.kicad_pcb]
2026-06-18 corner bevels, silkscreen spacing
    [Analog.kicad_sch, Digital.kicad_sch, HandymanSchematic_F4.kicad_pcb]
2026-06-19 rev3 sent to fab
    [Digital.kicad_sch, HandymanSchematic_F4.kicad_pcb]
2026-07-01 st7789 wrestling
    [HandymanSchematic_F4.kicad_pcb]
2026-07-01 banished st7789
    [Digital.kicad_sch]
2026-07-01 switched to 1.3 inch oled
    [Digital.kicad_sch, HandymanSchematic_F4.kicad_pcb]
2026-07-11 new bom, shifted things for enclosure
    [HandymanSchematic_F4.kicad_pcb]
2026-07-11 attenuator simulation
    [Attenuator.kicad_pcb, Attenuator.kicad_sch]
2026-07-13 driver files for new OLED
2026-07-13 basic slop driver
2026-07-14 switched to fast mode i2c
2026-07-14 switched to pre-filtering the BAC inputs
2026-07-18 fixed display staying on inappropriately
    [BitstreamACF.c, BitstreamACF.h, NoiseGate.h, main.c]
2026-07-23 schematic changes for DFM
    [Analog.kicad_sch, Digital.kicad_sch]
2026-07-25 trace cleanup, silkscreen additions
    [HandymanSchematic_F4.kicad_pcb]
2026-07-26 set up BOM w supplier links fixing merge conflict
    [Analog.kicad_sch, Digital.kicad_sch]
2026-07-26 trashed old attenuator simulation
    [AttenuatorSim.kicad_pcb, AttenuatorSim.kicad_sch]
2026-07-27 added ground spring, rev5 at fab
    [Digital.kicad_sch, HandymanSchematic_F4.kicad_pcb]
2026-07-31 schematic and footprint tweaks
2026-08-07 wrestling w vertical display...
    [HandymanSchematic_F4.kicad_pcb]
2026-08-09 fixed errant F# reading
    [BitstreamACF.c, main.c]
2026-08-19 moved to front, routing and DRC done
    [Digital.kicad_sch, HandymanSchematic_F4.kicad_pcb]
2026-08-21 rev6 sent to fab
    [HandymanSchematic_F4.kicad_pcb]
2026-08-30 new BOM
    [HandymanSchematic_F4.kicad_pcb]
2026-09-29 noise schematic tweaks
    [Analog.kicad_sch, Attenuator.kicad_sch, Digital.kicad_sch, HandymanSchematic_F4.kicad_pcb]
2026-10-01 wider jack spacing, DRC passing
    [HandymanSchematic_F4.kicad_pcb]
2026-10-02 stitching vias, trace improvements
    [HandymanSchematic_F4.kicad_pcb]
2026-10-04 rev7 ready for fab
    [HandymanSchematic_F4.kicad_pcb]
2026-10-05 switched to FET controlled gate circuit
    [Analog.kicad_sch, Attenuator.kicad_sch, HandymanSchematic_F4.kicad_pcb]
2026-10-26 added de-ringing caps
2026-10-26 tuning tweaks, switched display to I2C fast mode
